grillbaer/esp32-lora-water-level-meter/doc/well-manhole-lora-rssi-test.ods

Sheet: Manholes raw
id | time | nodeaddr | appeui | gwaddr | modulation | datarate | snr | rssi | freq | accuracy | hdop | sats | provider | name | user_agent
11028417 | 2019-11-23 13:21:24 | t-beam-v1-0 | t-beam-ttn-tracker | 58A0CBFFFE801C23 | LORA | SF7BW125 | 9.25 | -90.00 | 868300 | 0.00 | 2.0 | 4 | hdop | schacht | null
11028413 | 2019-11-23 13:21:14 | t-beam-v1-0 | t-beam-ttn-tracker | 58A0CBFFFE801C23 | LORA | SF7BW125 | 8.25 | -96.00 | 868100 | 0.00 | 1.7 | 5 | hdop | schacht | null
11028407 | 2019-11-23 13:21:04 | t-beam-v1-0 | t-beam-ttn-tracker | 58A0CBFFFE801C23 | LORA | SF7BW125 | 8.00 | -89.00 | 868500 | 0.00 | 2.2 | 5 | hdop | schacht | null
11028405 | 2019-11-23 13:20:54 | t-beam-v1-0 | t-beam-ttn-tracker | 58A0CBFFFE801C23 | LORA | SF7BW125 | 11.00 | -84.00 | 868300 | 0.00 | 1.3 | 6 | hdop | schacht | null
11028399 | 2019-11-23 13:20:44 | t-beam-v1-0 | t-beam-ttn-tracker | 58A0CBFFFE801C23 | LORA | SF7BW125 | 10.75 | -91.00 | 868100 | 0.00 | 1.7 | 6 | hdop | schacht | null
11028394 | 2019-11-23 13:20:34 | t-beam-v1-0 | t-beam-ttn-tracker | 58A0CBFFFE801C23 | LORA | SF7BW125 | 4.50 | -107.00 | 867100 | 0.00 | 3.7 | 5 | hdop | schacht | null
11028380 | 2019-11-23 13:20:14 | t-beam-v1-0 | t-beam-ttn-tracker | 58A0CBFFFE801C23 | LORA | SF7BW125 | 9.50 | -93.00 | 868300 | 0.00 | 2.0 | 5 | hdop | schacht | null
11028376 | 2019-11-23 13:20:04 | t-beam-v1-0 | t-beam-ttn-tracker | 58A0CBFFFE801C23 | LORA | SF7BW125 | 9.00 | -95.00 | 868100 | 0.00 | 2.0 | 4 | hdop | schacht | null
11028369 | 2019-11-23 13:19:54 | t-beam-v1-0 | t-beam-ttn-tracker | 58A0CBFFFE801C23 | LORA | SF7BW125 | 7.25 | -93.00 | 868500 | 0.00 | 2.0 | 4 | hdop | schacht | null
11028363 | 2019-11-23 13:19:44 | t-beam-v1-0 | t-beam-ttn-tracker | 58A0CBFFFE801C23 | LORA | SF7BW125 | 9.50 | -93.00 | 868300 | 0.00 | 2.0 | 4 | hdop | schacht | null
11028358 | 2019-11-23 13:19:34 | t-beam-v1-0 | t-beam-ttn-tracker | 58A0CBFFFE801C23 | LORA | SF7BW125 | 9.25 | -95.00 | 868100 | 0.00 | 1.7 | 5 | hdop | schacht | null
11028349 | 2019-11-23 13:19:24 | t-beam-v1-0 | t-beam-ttn-tracker | 58A0CBFFFE801C23 | LORA | SF7BW125 | 8.25 | -94.00 | 867900 | 0.00 | 2.0 | 4 | hdop | schacht | null
11028346 | 2019-11-23 13:19:14 | t-beam-v1-0 | t-beam-ttn-tracker | 58A0CBFFFE801C23 | LORA | SF7BW125 | 7.25 | -89.00 | 868500 | 0.00 | 1.7 | 5 | hdop | schacht | null
11028343 | 2019-11-23 13:19:04 | t-beam-v1-0 | t-beam-ttn-tracker | 58A0CBFFFE801C23 | LORA | SF7BW125 | 9.00 | -93.00 | 868300 | 0.00 | 2.0 | 5 | hdop | schacht | null
11028341 | 2019-11-23 13:18:54 | t-beam-v1-0 | t-beam-ttn-tracker | 58A0CBFFFE801C23 | LORA | SF7BW125 | 9.25 | -95.00 | 868100 | 0.00 | 3.5 | 5 | hdop | schacht | null
11028330 | 2019-11-23 13:18:34 | t-beam-v1-0 | t-beam-ttn-tracker | 58A0CBFFFE801C23 | LORA | SF7BW125 | 8.50 | -89.00 | 868300 | 0.00 | 1.7 | 5 | hdop | schacht | null
11028329 | 2019-11-23 13:18:24 | t-beam-v1-0 | t-beam-ttn-tracker | 58A0CBFFFE801C23 | LORA | SF7BW125 | 10.00 | -90.00 | 868100 | 0.00 | 1.7 | 5 | hdop | schacht | null
11028325 | 2019-11-23 13:18:14 | t-beam-v1-0 | t-beam-ttn-tracker | 58A0CBFFFE801C23 | LORA | SF7BW125 | 10.25 | -90.00 | 867700 | 0.00 | 1.7 | 5 | hdop | schacht | null
11028319 | 2019-11-23 13:18:04 | t-beam-v1-0 | t-beam-ttn-tracker | 58A0CBFFFE801C23 | LORA | SF7BW125 | 7.75 | -91.00 | 868500 | 0.00 | 1.7 | 5 | hdop | schacht | null
11028315 | 2019-11-23 13:17:54 | t-beam-v1-0 | t-beam-ttn-tracker | 58A0CBFFFE801C23 | LORA | SF7BW125 | 9.25 | -87.00 | 868300 | 0.00 | 1.7 | 5 | hdop | schacht | null
11028312 | 2019-11-23 13:17:44 | t-beam-v1-0 | t-beam-ttn-tracker | 58A0CBFFFE801C23 | LORA | SF7BW125 | 9.75 | -93.00 | 868100 | 0.00 | 1.7 | 5 | hdop | schacht | null
11028305 | 2019-11-23 13:17:34 | t-beam-v1-0 | t-beam-ttn-tracker | 58A0CBFFFE801C23 | LORA | SF7BW125 | 6.75 | -91.00 | 868500 | 0.00 | 1.7 | 5 | hdop | schacht | null
11028302 | 2019-11-23 13:17:24 | t-beam-v1-0 | t-beam-ttn-tracker | 58A0CBFFFE801C23 | LORA | SF7BW125 | 9.00 | -88.00 | 868300 | 0.00 | 1.3 | 6 | hdop | schacht | null
11028299 | 2019-11-23 13:17:14 | t-beam-v1-0 | t-beam-ttn-tracker | 58A0CBFFFE801C23 | LORA | SF7BW125 | 8.75 | -95.00 | 868100 | 0.00 | 1.7 | 5 | hdop | schacht | null
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
11028076 | 2019-11-23 13:05:39 | t-beam-v1-0 | t-beam-ttn-tracker | 58A0CBFFFE801C23 | LORA | SF7BW125 | 9.50 | -59.00 | 867100 | 0.00 | 1.4 | 10 | hdop | schacht | null

Sheet: Manholes inside
Manhole absorption well, about 10m to GW, 1-2m through concrete and soil
Mode | SNR | RSSI [dBm]
SF7BW125 | 9,0 | -84
SF7BW125 | 7,5 | -79
SF7BW125 | 8,8 | -84
SF7BW125 | 9,5 | -82
SF7BW125 | 9,3 | -84
SF7BW125 | 7,5 | -80
SF7BW125 | 9,8 | -87
Median | 9,0 | -84
Manhole production well, about 20m to GW, 2-4m through concrete and soil
Mode | SNR | RSSI [dBm]
SF7BW125 | 9,5 | -93
SF7BW125 | 9,0 | -95
SF7BW125 | 7,3 | -93
SF7BW125 | 9,5 | -93
SF7BW125 | 9,3 | -95
SF7BW125 | 8,3 | -94
SF7BW125 | 7,3 | -89
SF7BW125 | 9,0 | -93
SF7BW125 | 9,3 | -95
Median | 9,0 | -93
Outside of manhole:
my GW |  | -60
Mering BF |  | -118 | (only one message)
