grillbaer/esp32-lora-water-level-meter/(commit log)

2019-11-17 First working measurement PoC
    [pressure-sensor-data.ods]
2019-12-05 first working prototype and hello world TTN LoRa
2019-12-05 image of first working prototype on breadboard
    [well-manhole-lora-rssi-test.ods]
2019-12-07 power consumption optimization first steps
    [battery-consumption.ods]
2019-12-09 power consumption optimizations
    - deep sleep with LMIC session restore
    - changed board to LOLIN32, some pin adjustments
    - no OLED display any more
    [battery-consumption.ods]
2019-12-09 power consumption measurements
    [battery-consumption.ods]
2020-01-01 optimized deep sleep power consumption
2020-01-02 added battery monitoring and updated some docs
    [battery-consumption.ods]
2020-01-02 updated battery estimation
    [battery-consumption.ods]
2020-01-03 added first KiCad circuit diagram
    [water-level-meter.kicad_pcb, water-level-meter.sch]
